Oldfusiondesigns/OFD_Noidcore_Straight/README.md

# OFD_Noidcore_Straight



What is noidcore?

•	Noidcore is the OOD x Eli Wu Neutron Solenoid powered version of the popular flycore platform!  This allows for native semi-automatic operation, and easy select fire with addition of a micro controller. 

•	Noidcore is a 90% complete blaster awaiting your new shell, design, or integration!  I’ve done all the work on flywheel spacing, pusher mechanisms, and even a complete magwell with detent or release! 

•	The goal of Noidcore is to allow designers new and old to focus on creating exciting new designs with a proven flywheel core that’s simple to build and has compact geometry to integrate

**Details**

•	Compatible with ANY Flywheel (From FTW to Banned Blasters)

•	Straight Noidcore compatible with Talons and Tachi magazines

•	Compatible with any 130 profile motor (can fit 132, 180s)

•	Experimental top load capability

•	Full steps provided to create your own new and exciting blasters!

**Licensing and Production**

•	Noidcore is licensed under CC-BY-SA-NC: https://creativecommons.org/licenses/by-nc-sa/2.0/

•	You have permission to print as many as you like for yourself, and remix the files in any way you like with attribution, but you CANNOT sell files or prints without my permission or coming to an agreement.

**Hardware List**

(2) 130 motors

(1) OOD x Eli Wu Neutron solenoid

(1) 1n4001 Diode – optional but recommended

(4) m2x5mm motor screws

(4) m3x8mm socket head cap screws

(8-9) M3 x 5mm diameter x 6mm deep heat set inserts (longer ones may not work)

 (2) M2.6x10mm toy screws
 
 (1) Spring 20mm in length less than 7mm in diameter for mag release (Recommend McMaster 9657K297 Trimmed to ~20-22mm)

**What should I print?**

•	Nightingale – 19.5mm-20mm crush 

•	Smaller Baby Banshee – 19.8mm crush

•	FTW/Night Owl/Baby Banshee wheels – 22-23mm crush

•	Spartan wheels – 23.5mm crush

•	Hurricane/Pulsar – 32.5-33.5mm crush

•	Full size wheels – 39.5-43mm crush

•	Banned Blasters – 40mm crush

•	Pusher guides: I recommend low-aligned pusher guides
