Oldfusiondesigns/OFD_Noidcore_Straight/STEPs/OFD_NOIDCORE_STRAIGHT_FULL_42MM_V1.STEP

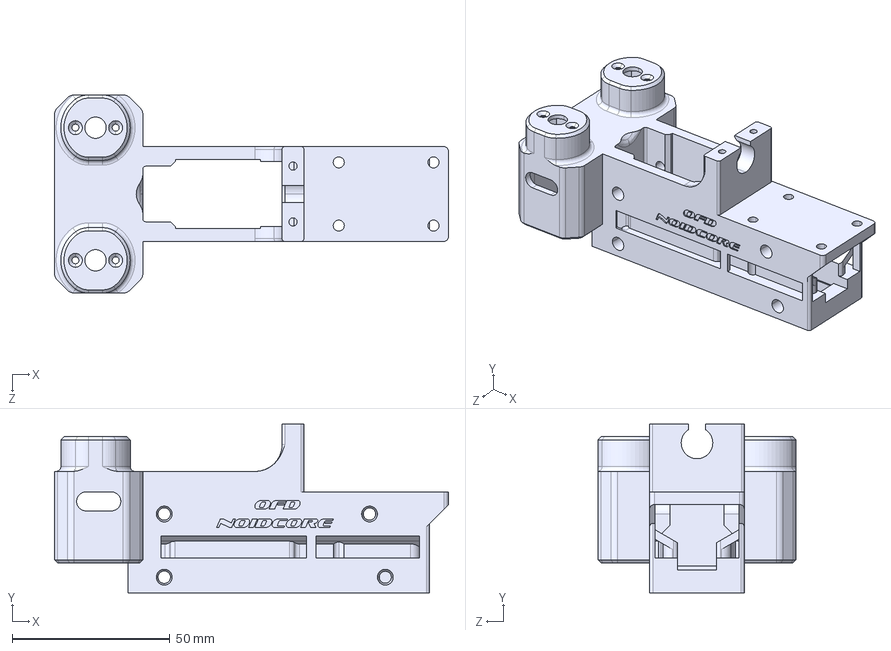
[picture p8: CAD file, 2023-03-22]
STEPs/OFD_NOIDCORE_STRAIGHT_FULL_42MM_V1.STEP
124.8 x 53.5 x 62.7 mm
