Oldfusiondesigns/OFD_Noidcore_Straight/STEPs/OFD_NOIDCORE_STRAIGHT_TRACEUR_25MM_V1.step

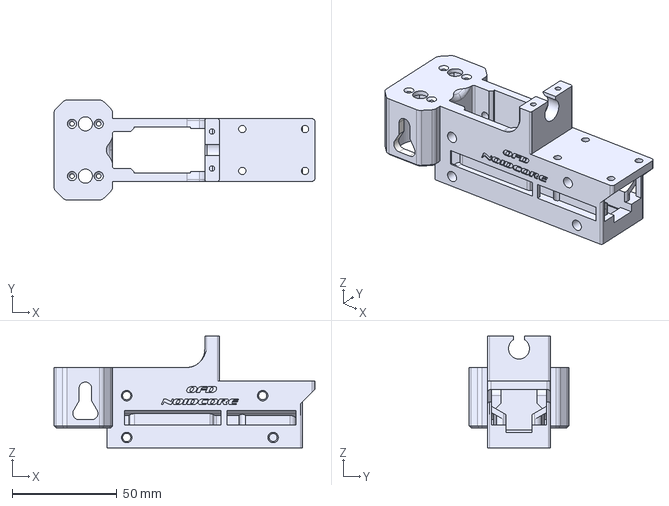
[picture p9: CAD file, 2024-01-23]
STEPs/OFD_NOIDCORE_STRAIGHT_TRACEUR_25MM_V1.step
124.8 x 47.7 x 53.5 mm
