Oldfusiondesigns/OFD_Noidcore_Straight/STLs/OFD_NOIDCORE_STRAIGHT_HURR_33.5MM_V2.STL

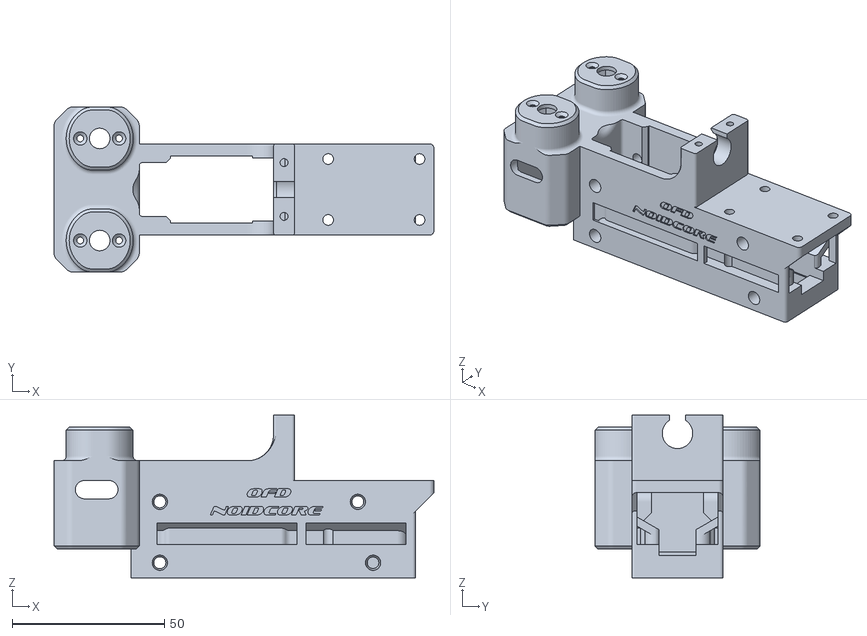
[picture p10: CAD file, 2023-03-29]
STLs/OFD_NOIDCORE_STRAIGHT_HURR_33.5MM_V2.STL
124.7 x 54.2 x 53.5
