Oldfusiondesigns/OFD_Noidcore_Straight/STEPs/NOIDCORE_Pusher_Guide_Low_Straight_V1.STEP

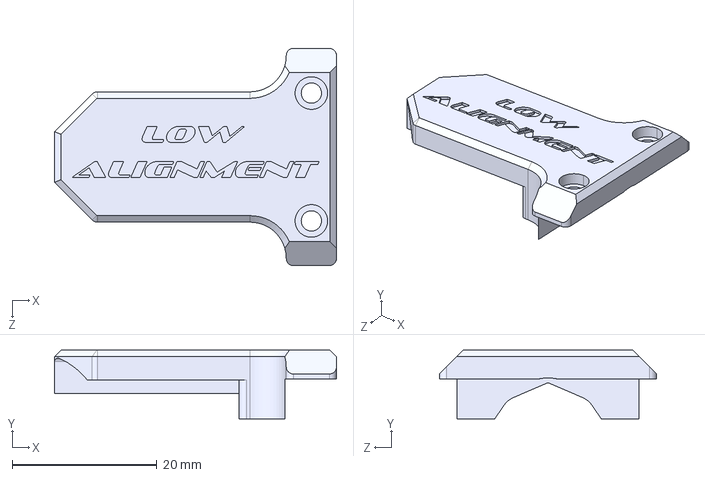
[picture p11: CAD file, 2023-03-22]
STEPs/NOIDCORE_Pusher_Guide_Low_Straight_V1.STEP
38.9 x 9.50 x 30.0 mm
