Oldfusiondesigns/OFD_Noidcore_Straight/STEPs/OFD_NOIDCORE_STRAIGHT_FTW_22.5MM_V1.STEP

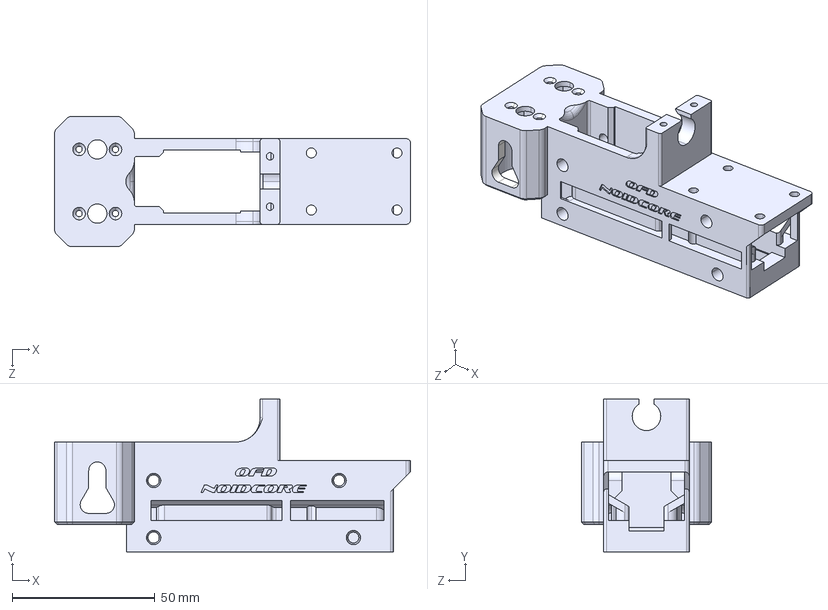
[picture p12: CAD file, 2023-03-22]
STEPs/OFD_NOIDCORE_STRAIGHT_FTW_22.5MM_V1.STEP
124.8 x 53.5 x 45.7 mm
