Oldfusiondesigns/OFD_Noidcore_Straight/STEPs/Straight_Mag_Release_V1.STEP

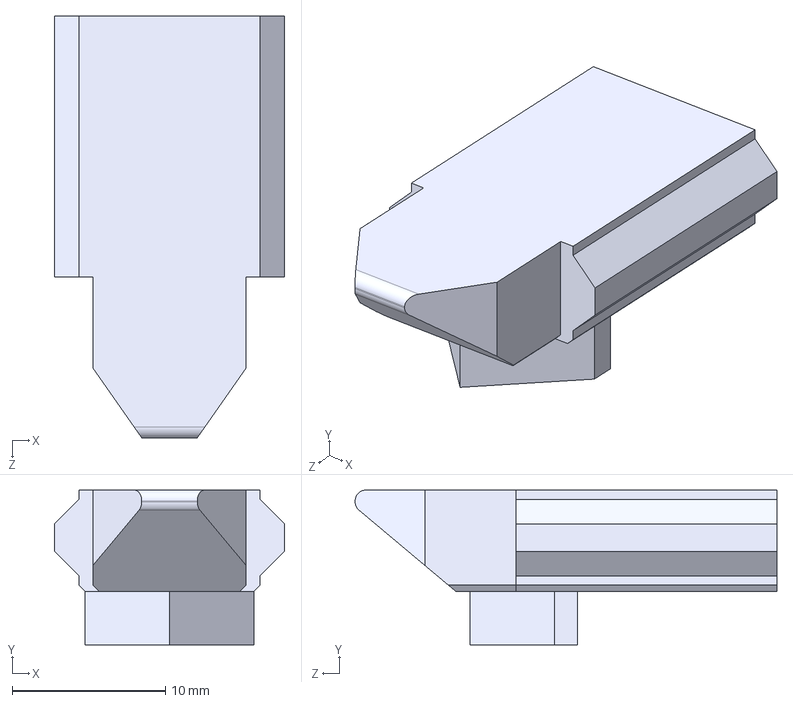
[picture p14: CAD file, 2023-03-22]
STEPs/Straight_Mag_Release_V1.STEP
15.0 x 10.1 x 27.5 mm
