Oldfusiondesigns/OFD_Noidcore_Straight/STEPs/Straight_Mag_Detent_V1.STEP

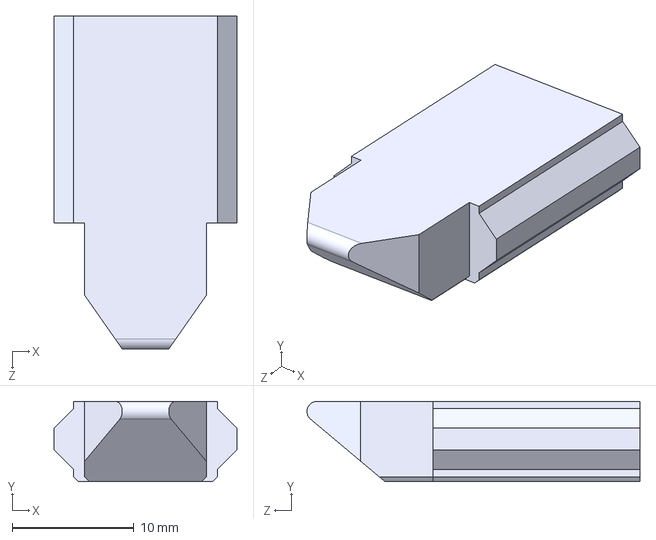
[picture p15: CAD file, 2023-03-22]
STEPs/Straight_Mag_Detent_V1.STEP
15.0 x 6.60 x 27.4 mm
