Oldfusiondesigns/OFD_Noidcore_Straight/(list of files, cad)

Other CAD files:
STEPs/OFD_NOIDCORE_STRAIGHT_FULL_40MM_V1.STEP
STEPs/OFD_NOIDCORE_STRAIGHT_FULL_41MM_V1.STEP
STEPs/OFD_NOIDCORE_STRAIGHT_FULL_41.5MM_V1.STEP
STEPs/OFD_NOIDCORE_STRAIGHT_FULL_40.5MM_V1.STEP
STEPs/OFD_NOIDCORE_STRAIGHT_FULL_39.5MM_V1.STEP
STEPs/OFD_NOIDCORE_STRAIGHT_FULL_43MM_V1.STEP
STLs/OFD_NOIDCORE_STRAIGHT_HURR_32.5MM_V2.STL
STLs/OFD_NOIDCORE_STRAIGHT_HURR_33MM_V1.STL
STEPs/OFD_NOIDCORE_STRAIGHT_NGALE_19.5MM_V1.STEP
STEPs/OFD_NOIDCORE_STRAIGHT_NGALE_20MM_V1.STEP
STEPs/OFD_NOIDCORE_STRAIGHT_FTW_23MM_V1.STEP
STEPs/OFD_NOIDCORE_STRAIGHT_SPARTAN_23.5MM_V1.STEP
STEPs/OFD_NOIDCORE_STRAIGHT_NGALE_19.8MM_V1.STEP
STEPs/OFD_NOIDCORE_STRAIGHT_FTW_22MM_V1.STEP
STLs/NOIDCORE_Pusher_Guide_High_Straight_V1.STL
STLs/NOIDCORE_Pusher_Guide_Low_Straight_V1.STL
STLs/OFD_NOIDCORE_STRAIGHT_FTW_22.5MM_V1.STL
STLs/OFD_NOIDCORE_STRAIGHT_FTW_22MM_V1.stl
STLs/OFD_NOIDCORE_STRAIGHT_FTW_23MM_V1.STL
STLs/OFD_NOIDCORE_STRAIGHT_FULL_39.5MM_V1.STL
STLs/OFD_NOIDCORE_STRAIGHT_FULL_40.5MM_V1.STL
STLs/OFD_NOIDCORE_STRAIGHT_FULL_40MM_V1.STL
STLs/OFD_NOIDCORE_STRAIGHT_FULL_41.5MM_V1.STL
STLs/OFD_NOIDCORE_STRAIGHT_FULL_41MM_V1.STL
STLs/OFD_NOIDCORE_STRAIGHT_FULL_42MM_V1.STL
STLs/OFD_NOIDCORE_STRAIGHT_FULL_43MM_V1.STL
STLs/OFD_NOIDCORE_STRAIGHT_NGALE_19.5MM_V1.STL
STLs/OFD_NOIDCORE_STRAIGHT_NGALE_19.8MM_V1.STL
STLs/OFD_NOIDCORE_STRAIGHT_NGALE_20MM_V1.STL
STLs/OFD_NOIDCORE_STRAIGHT_SPARTAN_23.5MM_V1.STL
STLs/OFD_NOIDCORE_STRAIGHT_TRACEUR_25MM_V1.stl
STLs/Straight_Mag_Detent_V1.stl
STLs/Straight_Mag_Release_V1.stl
